Heinrich70/Heinrich-13-Di-70cc-hybrid-pitbike/Photos/motor assembly.jpg

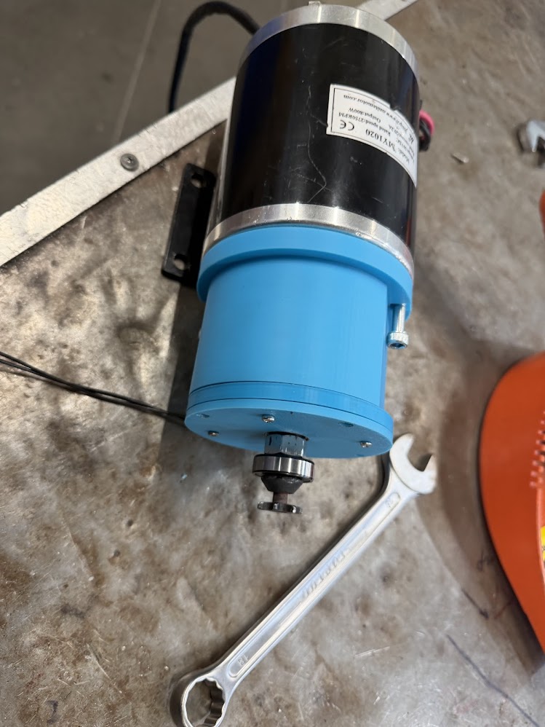
Photos/motor assembly.jpg
