Heinrich70/Heinrich-13-Di-70cc-hybrid-pitbike/Cad designs/PCBs/Fixed pptc.png

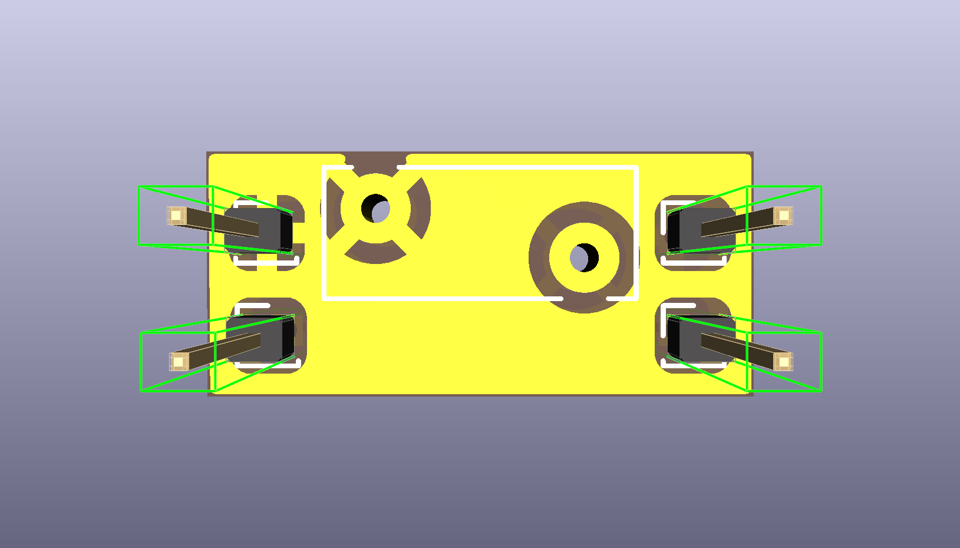
Cad designs/PCBs/Fixed pptc.png
