Heinrich70/Heinrich-13-Di-70cc-hybrid-pitbike/AS91904 Electronics Heinrich Venter.pptx

## AS91904 Electronics Outcome

Student Name: Heinrich venter
Project Name:hybrid pitbike

## Project Details

Describe your project here: This project is a hybrid 70cc pit bike that combines a petrol engine with an 800 W, 36 V electric motor to improve low-speed torque and acceleration. An ESP32 uses analogue and digital Hall effect sensors to monitor throttle position and engine speed, then controls the electric motor through a motor controller. An electromagnetic clutch engages the motor only when assistance is needed, creating a hybrid drivetrain that combines mechanical and electronic systems.

## Techniques used

Technique 1: Implementing communication protocols
Evidence:
I will meet this requirement by using I2C communication to connect the ESP32 to the OLED dashboard display. This allows important information such as speed and RPM data to be transferred to the display while only using two communication pins, leaving the remaining pins available for other sensors and system components.

Techniques could be:
implementing communication protocols
Wireless transfer of information
Feedback control
Implementing software flags and interrupts
CAD design, 3D printing, CNC, PCB making
filtering, noise and EMI suppression.

Technique 2: Filtering, noise and EMI suppression
Evidence:
I will meet this requirement by adding filtering components, such as 0.1µF ceramic capacitors, to reduce electrical noise caused by the high-current electric motor. This will improve the reliability of the Hall effect sensors, LED indicators, and battery monitoring system by providing more stable and accurate readings.

## Relevant Implications

Description of Implication (What Where Why) | Explanation of Implication (How, Why) | Evidence of addressing.
Accessibility for the pitbike means the bike’s controls, indicators, and basic functions need to be understandable and manageable for a range of riders. This includes clear visual indicators, easy-to-reach switches, and controls that don’t require excessive strength. | It is important because riders need to operate the hybrid system, throttle, and display safely without confusion. I will address this by using clearly labelled switches, simple control layouts, and making sure components like the electric–petrol mode indicator are easy to read. | This was done by coding and producing a dashboard with 2 lines of leds one for the motor rpm and the other for the engine rpm to see when the clutch has to disengage and when the gear on the engine has to change as well as a Oled screen to see the speed of the bike as well as a second screen for sensor values so that troubleshooting can be done on the fly without needing a phone (for simpler usability)
Usability relates to how easy it is to understand and use the pitbike’s hybrid systems, such as switching modes, checking battery levels, or starting the bike. The design needs to feel intuitive even for new riders. | It matters because if the interface is confusing, the rider could misuse the bike or struggle during operation. I will address this by keeping the hybrid controls simple, limiting unnecessary switches, and providing a logical layout similar to standard pitbikes so it feels familiar. | Mapping the analogue throttle Hall sensors linearly alongside the petrol throttle, using software constraints (constrain(throttlePercent, 0, 100)).
Functionality refers to how well the 70cc hybrid pitbike performs its intended purpose—delivering reliable petrol and electric operation, smooth power delivery, and stable riding. It also includes ensuring the components (battery, controller, mechanical systems) work together correctly. | It is important because the bike must be reliable and safe. I will address this by testing the hybrid system regularly, checking wiring, ensuring the mechanical and electrical parts don’t interfere with each other, and confirming that power output remains stable. | Offloading sensor pulses to low-overhead interrupts (enginePulse, matchPulse, motorPulse), allowing the VCU (vehicle control unit)to match shaft speeds before engaging the 24V clutch.
Aesthetics for the pitbike include the visual design—how the hybrid components are integrated, how tidy the wiring is, and the overall look of the bike. A clean, professional aesthetic helps the bike feel intentional rather than thrown together. | It is important because a well-presented bike improves user confidence and makes maintenance easier. I will address this by organising wiring neatly, using matching colours or covers, and ensuring added components blend with the original frame so the hybrid upgrade looks cohesive. | Consolidating loose jumper wires onto a custom dual-layer PCB enclosed in a watertight, form-fitting 3D-printed ABS structural housing shell.

## Original Design

Insert diagram here of electronics outcome
v

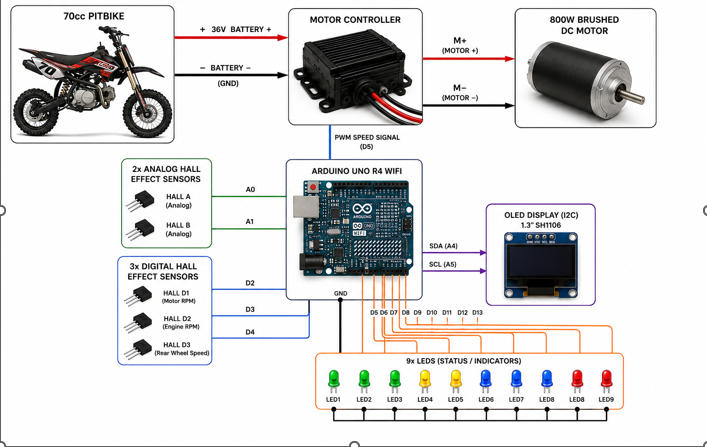
[picture p3: figure]

Made by ai

## Behaviour and function

The behaviour of the electronics is as follows.
Electric Motor Control
An analogue Hall effect sensor is used as the throttle input to send a signal to the 36 V motor controller, which controls the 800 W electric motor.
A 36 V to 12 V DC-DC buck converter is used to safely power the Arduino Uno R4 WiFi from the bike’s main battery system.
Hybrid Power Switching
A 24 V electromagnetic clutch is used to connect and disconnect the electric motor from the drivetrain.
Both the petrol engine and electric motor provide power during acceleration to improve low-speed torque.
At higher speeds, the electric motor disengages because the petrol engine can operate at a higher RPM.
A second Hall effect sensor is connected to the clutch lever, allowing the rider to manually disengage the electric motor when required.
RPM Matching System
Two digital Hall effect sensors measure the RPM on both sides of the electromagnetic clutch.
The Arduino uses this data to match the electric motor speed with the drivetrain before engaging the clutch, preventing drivetrain damage and sudden speed changes.

## Slide 7

Speed Monitoring
A digital Hall effect sensor mounted near the rear wheel measures wheel rotation speed.
The Arduino calculates the bike’s speed and displays it on the dashboard.
Dashboard Display
An OLED display and LED indicators provide the rider with real-time information.
The dashboard displays:
Vehicle speed
Engine RPM
Electric motor RPM
Battery percentage

## Explaining relevant communication protocols

I am using I2C communication between the ESP32and the OLED dashboard display. I2C works by using two communication lines: SDA (Serial Data) to transfer information and SCL (Serial Clock) to synchronise the data transfer. The ESP32 acts as the master device, sending information to the OLED display, which acts as the slave device. This allows the system to display real-time information such as speed rpm and current gear position aswell as sensor values so that the rider/user can diagnose the system if there is one and the don’t have access to the esp32s wifi signal

I selected I2C because it only requires two Arduino pins, leaving more available pins for the other sensors used in the bike, such as Hall effect sensors and RPM sensors. I2C also provides enough communication speed for a small OLED display while allowing additional devices to be added to the same communication bus in the future.

## Iterated Design

Feedback:

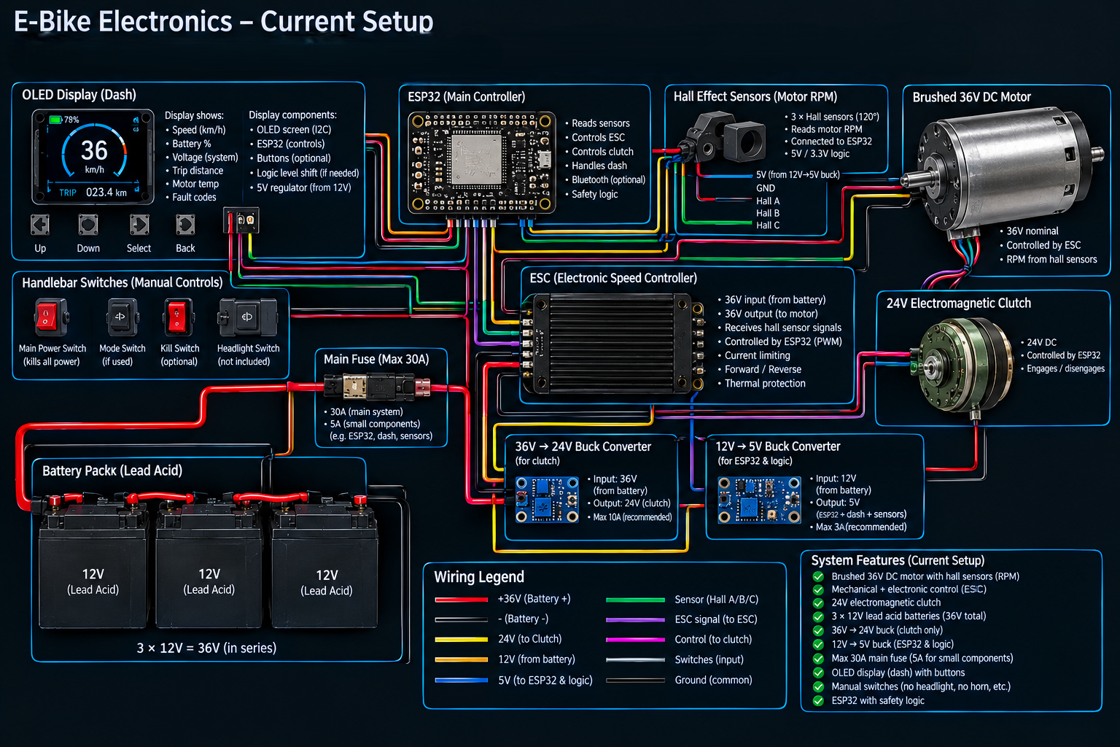
[picture p4: figure]

Made by ai

## Components and Systems

## Choice of Component/System 1: controller

Chosen
ESP32-s3

Alternative 1
Arduino r4 wifi

Alternative 2
Arduino r3

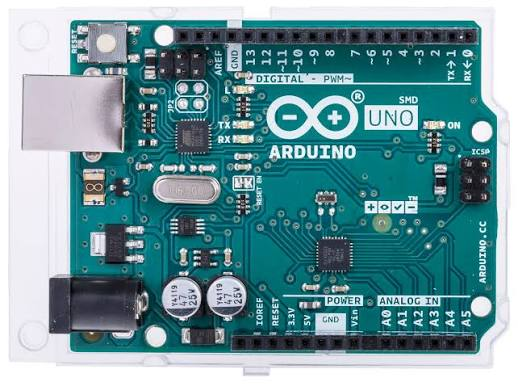
[picture p5: figure]
Arduino Uno Rev 3 SMD, A000073
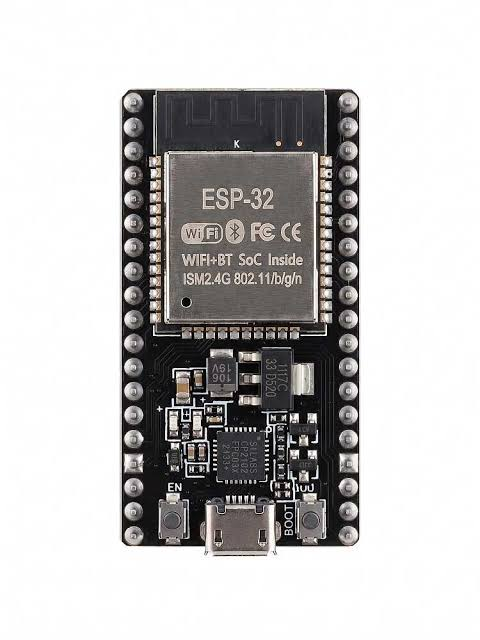
[picture p6: figure]
Buy ESP32 ESP-32S WiFi+ Bluetooth Development Board
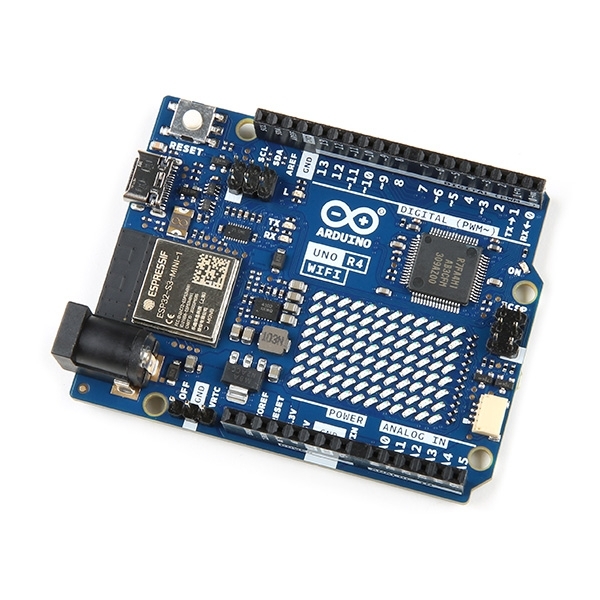
[picture p7: figure]
Arduino UNO R4 WiFi - SparkFun Electronics

Justification of choice made
I chose the esp32 for its native wifi and Bluetooth capabilities aswell as its increased gpio pins compared to other boards, another reason is that it is faster at reading sensor readings

## Component/System 1

Explanation of component-brain
The ESP32 is the main microcontroller used in my project. It is a microcontroller with a wifi component onboard meaning it can be controlled wirelessly using wifi, it also has gpio pins on the side so that sensors and components like a PCB can be added for adding more components

Component Picture

Component test log:
Have been found to be much more reliable and easier to use compared to the r4 and the r3 arduinos aswll as the wifi capabilities natively on the esp compared to the wifi connection on the r4

## Reliability Testing

Multiple test

Reliability notes from testing:When testing the original single-core Arduinos, the display setup had a bit of lag. Every time the controller had to refresh the OLED layout or stream data over the network, it would momentarily freeze up, missing live switch changes and slowing down the screen update rate. The hardware simply didn't have enough processing power to keep the graphical interface smooth while managing the wireless network connection at the same time.

Analyse notes from testing and note changes to be made:To fix the interface lag, I chose to use a dual-core ESP32 chip. This lets the processor handle multiple tasks at once: Core 0 runs the local code loop to handle instant switch inputs and refresh the U8g2 OLED screens without any delay, while Core 1 runs the background web server to host the JSON dashboard page. This ensures the live user interfaces update quickly and smoothly without crashing.

## Choice of Component/System 2:physical controls

Chosen
Hall effect sensor

Alternative 1
Potentiometer

Alternative 2
optical encoder

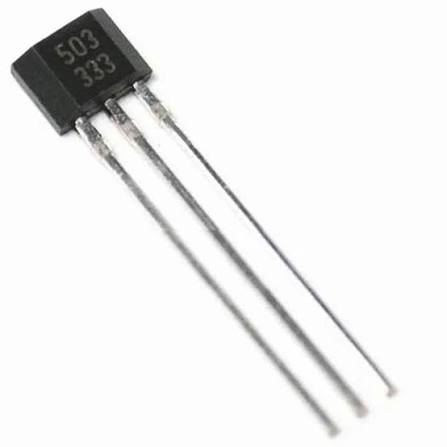
[picture p8: figure]
UGN3503UA Hall Effect Sensor | Afterpay & ZipPay Available | Click & Collect | Jaycar
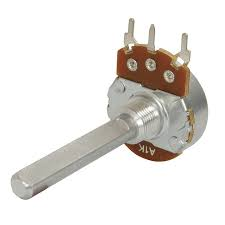
[picture p9: figure]
25k Ohm Logarithmic (A) Single Gang 24mm Potentiometer | Afterpay & ZipPay Available | Click & Collect | Jaycar
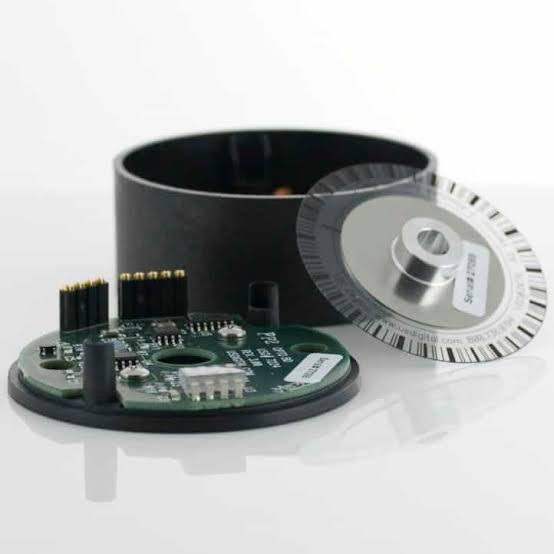
[picture p10: figure]
Optical Encoders: How They Work, Types & Applications

Justification of choice made
The reason why I chose the hall effect sensor is due to simplicity and the fact that it use magnets for signal input meaning nothing is touching so no friction and near zero wear in the parts, it is also very easy to make a custom casing for it to be held in place where ever its needed

## Component/System 2

Explanation of component-speed/rpm sensing
The speed and RPM tracking system uses digital Hall effect sensors with neodymium magnets attached to the rotating parts of the bike, including the clutches and rear wheel. When the magnet passes the sensor, it detects the change in the magnetic field and sends a digital signal (0V or 5V) to the Arduino. These signals are used by the Arduino to calculate the RPM of the drivetrain and the speed of the bike by measuring the time between each pulse.

Component Picture

Component Test Log:
there is a bit of electromagnetic interference from other magnets like the clutch and the engine, adding a 0.1uf capacitor across the signal and gnd wires did reduce this emi

## Reliability Testing

Multiple test

Reliability notes from testing: the analog hall sensors still have a little bit of bounce to its signal but still readable tho

Analyse notes from testing and note changes to be made: twisting the 3 wires ontop of eachother which creates an inductor which resist signal roughness

## Choice of Component/System 3

Chosen
1.3” i2c Oled screen

Alternative 1
Lcd screen

Alternative 2
SPI TFT colour display

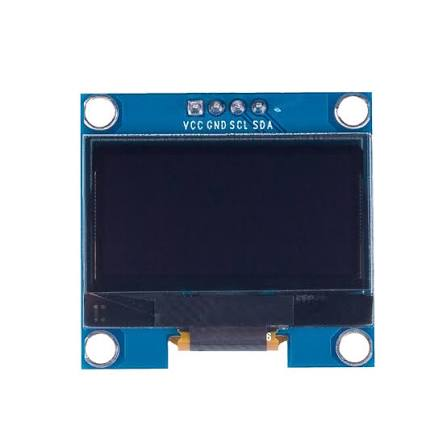
[picture p11: figure]
1.3" IIC I2C Serial 128x64 SSH1106 OLED Display Module | SunFounder
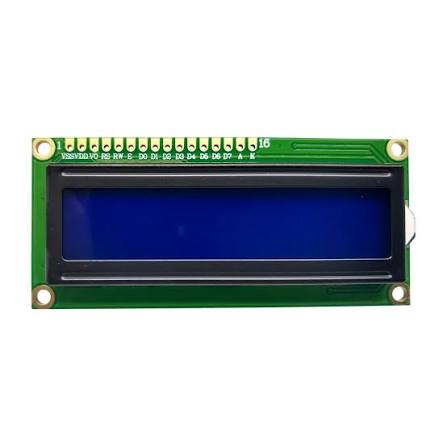
[picture p12: figure]
Dot Matrix White on Blue LCD 16x2 Character
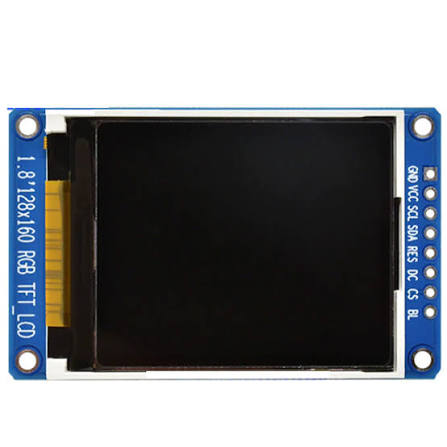
[picture p13: figure]
TFT LCD - Full Colour TFT LCD Display 1.8 inch(128x160) SPI Interface

Justification of choice made
The chosen 1.3" I2C OLED display was selected because it provides a clear and efficient way to display information from the ESP. It is not only bright enough to be seen in the day but only uses 4 wires (gnd, 3v3, sda and scl) (scl:serial clock sda: serial data) wich is also very easy to programme and controll

## Component/System 3

Explanation of component-dashboard:The dashboard provides the rider with a real-time visual interface displaying operational telemetry. It features a 1.3" SH1106 I2C OLED display running in tandem with a custom 16-LED tachometer bar driven by an MCP23017 port expander.

Component Picture

Component Test Log: it works very nicely hardware wise but programme wise its lagging a bit so a separate screen (on the same oled) will be added to show sensor values that can b controlled by s switch to cycle through the 2 screens

## Reliability Testing

Multiple test

Reliability notes from testing:When I tested the dashboard out in the open, I realized the bare screen and circuit board were completely exposed to the elements. If it rained or mud splashed up while riding, water could easily get onto the contacts and cause an environmental short circuit. The screen was also vibrating a lot on the handlebars, which could loosen the wires over time.

Analyse notes from testing and note changes to be made:
to prevent environmental short circuits, I designed a sealed handlebar mounting dashboard cluster using 3D-printed parts. I integrated a transparent acrylic faceplate and cut a custom, shock-absorbing TPU gasket to seal the electronics safely away from weather exposure.

## Choice of Component/System 4

Chosen
Electromangetic clutch

Alternative 1
Automatic Centrifugal Clutch Mechanism.

Alternative 2
One way bearing

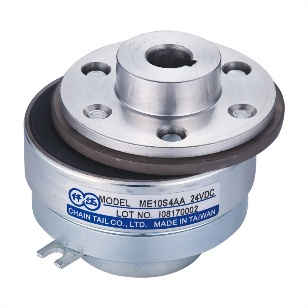
[picture p14: figure]
Chain Tail-ME1 Miniature Electromagnetic Bearing Mounted Clutch With Hub
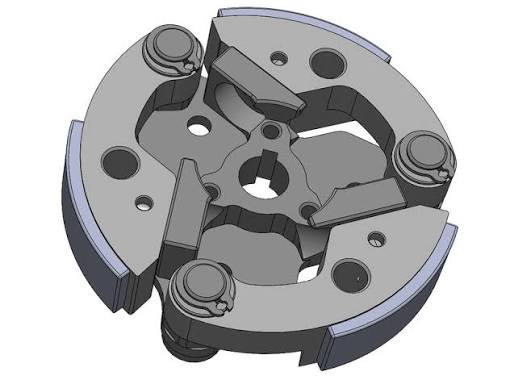
[picture p15: figure]
Three-shoe Centrifugal Clutch | Download Scientific Diagram
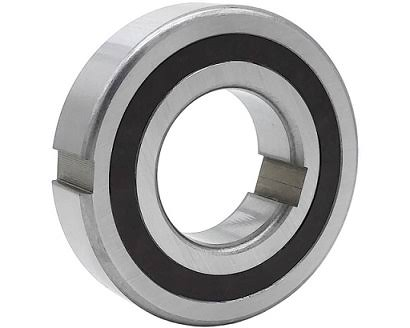
[picture p16: figure]
All about one way clutch bearing

Justification of choice made
I chose the electromagnetic clutch because, when a electric motor gets back driven it can cause something called back emf which is basically electric breaking but with a electromagnetic clutch yon can physically disconnect the 2 power units from each other specifically the electric motor which mean no back emf.

## Component/System 4

Explanation of component-electromagnetic clutch
The clutch system is used to connect and disconnect the 800W electric motor from the drivetrain. It uses a mechanical clutch mechanism controlled by a lever, with a sensor attached to detect when the clutch is being used. When the rider pulls the lever, the clutch disengages the motor from the drivetrain, allowing the motor to be safely disconnected. The sensor sends this information to the Arduino, allowing it to stop motor assistance and adjust the system accordingly.

Component Picture

Component Test Log:
The purpose of this test was to check that the manual clutch could reliably engage and disengage the 800W motor from the drivetrain. The clutch was connected to the motor system and tested under load to ensure it could separate the drive components correctly. Initial testing showed some resistance in the lever mechanism, causing the clutch plates to separate slowly. The linkage was cleaned, adjusted, and lubricated to fix this issue. After these changes, the clutch successfully completed ten engagement and disengagement tests without slipping, confirming that it worked correctly.

## Reliability Testing

Test your circuits at least 10 times

Reliability notes from testing:
Manual clutch assembly stress trials revealed initial instability and wobble, which were corrected by manually aligning the central hub to ensure proper clearance. Following this adjustment, the system demonstrated consistent, reliable performance throughout the remaining tests without mechanical failure.

Analysis Notes from Testing and Changes to be Made:
Testing showed that the high torque produced by the 800W motor puts significant load on the clutch assembly, making correct alignment important for reliable operation. Small amounts of misalignment can cause extra stress and increased wear on the drivetrain components. To improve the strength and reliability of the system, a custom sleeve will be manufactured to act as a central alignment piece. This will help keep the clutch and drivetrain components correctly positioned, reducing movement and improving long-term durability.

## Choice of Component/System 5

Chosen
PCB

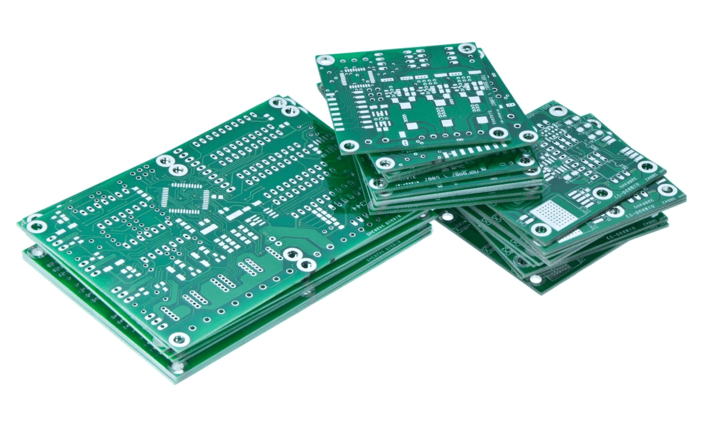
[picture p17: figure]
Printed Circuit Board Guide: PCB Design and Assembly

Alternative 1
Perfboard

Alternative 2
Strip boards

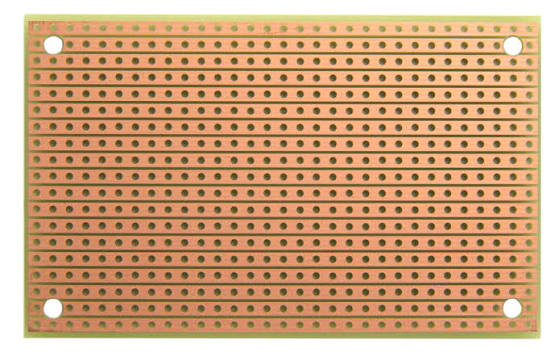
[picture p18: figure]
ST1 | StripBoard-Size 1 | BusBoard Prototype Systems
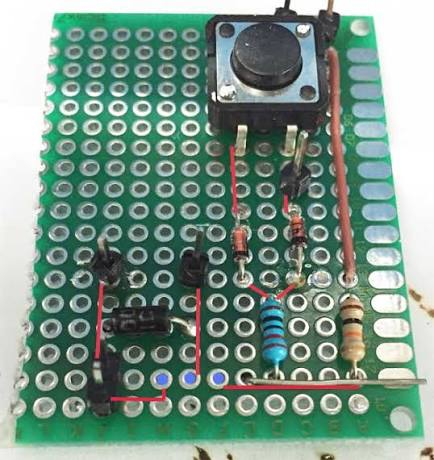
[picture p19: figure]
What to use to connect points on perf board - General Electronics - Arduino Forum

Justification of choice made
I chose a custom PCB because it gave me a cleaner and more reliable way of connecting all the electronics together. The PCB allowed me to place the Arduino, sensors, protection components and other circuits in one organised layout instead of having lots of separate wires. This was especially important because testing showed that electrical noise from the motor could affect the sensors. A PCB also made the final system more compact and reduced the chance of loose or incorrect connections.
I considered perfboard and stripboard, but both would have required more manual wiring and would have been harder to keep organised. The PCB was also easier to reproduce once the design was finished, making it the better choice for the final outcome.

## Component/System 5

Explanation of component-PCB
I designed a custom PCB to connect the Arduino UNO R4 to the different sensors and circuits used on the bike. It includes connections for the throttle and clutch Hall sensors, RPM sensors, battery voltage sensing, LEDs and the protection circuits. Having these connections on one board made the wiring cleaner and reduced the number of separate wires and connections. I also included filtering capacitors and protection components on the PCB based on problems found during testing. This made the final electronics more compact, organised and reliable.

Component Picture

Component Test Log: make sure to include protection to the circuit due to some components accidently being set to the wrong voltage can damage the delicate electronics in the system that when it gets damaged can cost a pretty penny to replace

## Reliability Testing

Test your circuits at least 10 times

Reliability notes from testing: I tested the PCB multiple times with the different circuits connected to make sure the board was reliable. I checked the sensor connections, battery voltage sensing, Arduino power connections and the protection circuits. During testing, I found that the high current from the motor could cause electrical noise and interference with the sensor signals, so 0.1 µF capacitors were added to the PCB to help filter the signals. I also included PPTC fuses on the PCB to protect the lower-current circuits if a fault or short circuit occurred. The electromagnetic clutch circuit was also protected with a Schottky diode and PPTC because testing showed that the electromagnet could release a high voltage back into the circuit when switched off. The PCB was then tested again with these changes to check that the sensors and protection circuits were working correctly and that the board could operate without damaging the Arduino or other components.

Analysis Notes from Testing and Changes to be made: The testing showed that the PCB needed both filtering and protection to be reliable when used with the rest of the bike. The 0.1 µF capacitors were added to reduce electrical noise, while the PPTC fuses gave the PCB protection from excessive current if a fault occurred. The Schottky diode was added to the clutch circuit to stop the voltage released by the electromagnet from travelling back through the PCB. These changes were made from the problems found during testing and improved the reliability of the final PCB by making the circuits more protected and less affected by the electrical noise from the motor.

## Final Outcome, Before Testing

Include a screenshot/video of the final outcome working before testing here

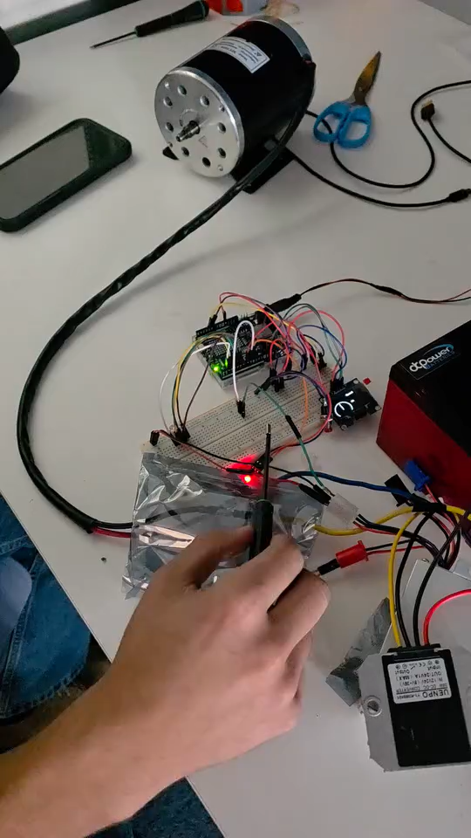
[picture p20: figure]
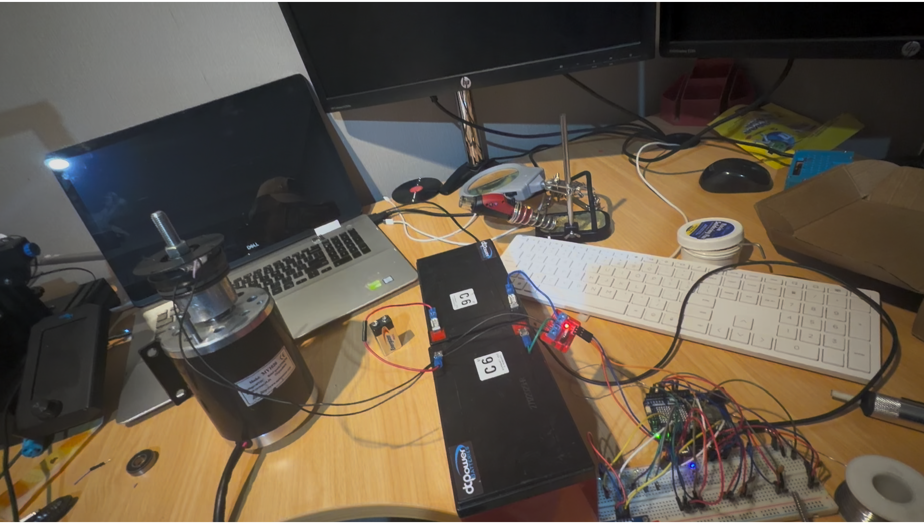
[picture p21: figure]

## Iteration of Development

Feedback on reliability and functionality of the system:
Some hybrid vehicles have a display that shows when the hybrid system is engaged. Adding a hybrid indicator light to the pitbike will let the rider know when the electric motor is assisting the petrol engine. This provides feedback that the hybrid system is working correctly and makes it easier to monitor the operation of the bike while riding.

Changes based off feedback (include picture or design):
An LED indicator/symbol will be added to the OLED display to show when the hybrid system is engaged. This gives the rider clear visual feedback that the electric motor is assisting the petrol engine and makes it easier to monitor the operation of the hybrid system while riding.

## Testing and Debugging

## Testing for functionality

Examples of testing, modifying and debugging include: using testing devices and testing strategies, testing expected, boundary and invalid inputs, changing board layout, improving component selection. You may test as you go

Project Specification | Test | Issues to be fixed, debugging, Notes
Electromagnetic clutch | Repeatedly engaged and disengaged the clutch using the ESP32-S3 microcontroller, driving an isolated optocoupled MOSFET switching loop. | issue: The clutch engaged reliably under software control, but mechanical alignment stress trials under load revealed structural shaft instability and clutch plate wobble. This slowed down plate separation and increased friction wear. Resolution: Machined a custom central steel sleeve component to act as a precision alignment piece. This completely eliminated the mechanical wobble, keeping the drivetrain components perfectly centered and ensuring long-term durability under heavy motor torque.
main PCB inside the dashboard | Plugged the PCB wit the Arduino inserted to the header pins. The Arduino fried due to unknown causes for the vin wasn’t plugged in and neither the voltage sensing, believed being the sensor wire for the throttle but in any case, it still broke. | Issue: Initial unshielded prototypes experienced catastrophic inductive feedback when switching off the electromagnetic clutch coil. The resulting ~200V inductive flyback spike traveled backward through the shared power rail, instantly frying the switching MOSFET and burning out the low-voltage microcontroller logic. Resolution: Redesigned the PCB layout to integrate a multi-stage hardware protection network. Wired a fast-acting Schottky diode in a reverse-biased configuration directly across the clutch coil leads to suppress inductive flyback spikes. Backed this up with a high-speed Zener d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
Throttle input/output | Handlebar grip rotation must shift the analogue input smoothly from 0.5V to 4.2V, mapped directly to a 0–100% PWM signal sent to the 36V high-voltage Electronic Speed Controller (ESC) to regulate the 800W motor | issue 1 (High-Voltage Failure): Initially, the PWM control signal trace was wired directly from the microcontroller to the ESC signal line. During high-load testing, common-ground voltage fluctuations and high-current spikes leaked directly backward from the 36V motor rail straight into the low-voltage electronics, completely frying the sensitive control circuit and blowing up the microprocessing chip. Resolution 1 (Galvanic Isolation): On the latest iterated PCB layout, I completely isolated the high-voltage drivetrain loop from the low-voltage logic gates by inserting a PC817 optocoupler i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

## Testing for reliability

Potential problem, original reliability | Test and change for reliability | Issues to be fixed, debugging, Notes
High-Frequency Electromagnetic Interference (EMI) along Data Rails | The digital Hall-effect RPM sensors were tested under full drivetrain load while running the 800W brushed DC motor. High-frequency electrical noise from the motor brushes induced phantom voltage spikes across the unshielded signal paths. | Diagnostic Outcome: Before filtering, the induced EMI noise caused severe sensor signal bounce and false edge-triggers, leading to corrupted, erratic RPM readings. Resolution: Soldered a 0.1µF ceramic decoupling capacitor in parallel directly across the VCC and GND pins of each sensor. Upstream signal lines were physically twisted into tight differential pairs along the frame rails. Retesting confirmed clean, stable pulse patterns with zero false triggers.
nductive Flyback Volts via Electromagnetic Coil Collapse | Cutting the power feed to the 24V electromagnetic clutch coil collapses its magnetic field, releasing a massive reverse-bias ~200V counter-EMF flyback spike back into the shared PCB power rail, risking total system destruction. | Diagnostic Outcome: Initial unshielded power cycles completely fried the switching MOSFET gates and instantly burned out the low-voltage microcontroller logic ports. Resolution: Engineered a multi-stage hardware protection network directly on the PCB traces. Wired a fast-switching Schottky diode in a reverse-biased configuration directly across the clutch coil leads to suppress inductive surges. Paired this with a high-speed Zener diode and a Transient Voltage Suppressor (TVS) diode to form a precise voltage clamp that shunts excess spike energy directly to ground. Added auto-resetting PPTC 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
Common-Ground Noise & High-Voltage Cross-Talk via PWM Signal Paths | Wiring the PWM throttle control trace directly from the microcontroller to the 36V high-voltage Electronic Speed Controller (ESC) allowed high-current surges and common-mode feedback to leak straight into the low-voltage control loop. | Diagnostic Outcome: High-amp draw spikes under hard acceleration bypassed the controller's internal logic gates, causing complete system failure and permanently destroying the microprocessing core. Resolution: Implemented absolute galvanic isolation on the latest dual-layer PCB layout by inserting a PC817 optocoupler directly into the PWM signal path. The ESP32-S3's internal LED controls the optocoupler using pure light transmission, completely breaking the physical electrical connection between the high-current 36V power system and the sensitive 5V/3.3V control electronics. This entirely el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

## Iteration after testing

- Feedback after testing:During integrated diagnostic testing of the system on the vehicle, two critical technical faults were discovered that severely limited operational reliability and data safety:
- Lack of Live Wireless Debugging: When tracking issues on a live vehicle moving under power, it was impossible to view sensor drifts or system states in real time using a standard hardwired serial monitor line, making calibration extremely slow and difficult.
- Volatile Memory Data Loss: The initial firmware layout calculated a runtime variable for the absolute highestSpeed reached. However, whenever the main power switch was killed or a PPTC circuit fuse reset the system, this critical data point was lost from the working RAM, preventing long-term tracking of drivetrain milestones.

Changes based off feedback (include picture or design):To completely address these feedback limitations, I executed a major dual-layered software iteration:
Asynchronous HTTP Data Server Integration: I embedded the <WiFi.h> and <WebServer.h> network libraries into the master ESP32-S3 software image. The controller is now programmed to configure a local Access Point routing node (SSID string pulled safely from SECRET_SSID). This architecture dynamically processes background web client connection requests and serves a live, structured JSON data packet string stream directly to the /data endpoint every 100ms. This permits non-blocking, real-time wireless diagnostics from a mobile phone browser interface while riding.
Non-Volatile NVS Preference Allocation: I integrated the core <Preferences.h> storage API framework to move structural variables out of volatile memory registers. Inside the processing loop, if a newly sampled wheelSpeed surpasses the stored record, the system automatically commits that float calculation straight into the ESP32-S3's non-volatile NVS flash memory partition under the namespace key "highest". This ensures telemetry records are saved safely during a complete vehicle power shutdown or automatic short-circuit fuse reset.
