Heinrich70/Heinrich-13-Di-70cc-hybrid-pitbike/AS91896-AS91906 Assessment Template.docx

# AS91896 or AS91906

# “Create an Advanced/Complex computer program”

Name:Heinrich Venter

Teacher: Mark Sutherland

Due Date:

## Project Brief

Please insert your brief statement in the following box

Create a plan for a program that will allow users to complete group bookings with a pricing total as per the brief.

2 different variables

2 if statements (or selection)

2 Loops

Output and input

Sequantial coding

2 of these Year 13’s:

- programming or writing code for a graphical user interface (GUI)
- reading from, or writing to, files or other persistent storage
- object-oriented programming using class(es) and objects defined by the student
- using types defined by the student
- using third party or non-core API, library or framework
- using complex data structures (e.g. stacks, queues, trees)

# Testing

This Section needs to be completed independently in order to get Merit or Higher.

Create a table here showing how you are going to test your application.

Test Scenario | Expected input and output | What actually happened | What need to be fixed
Throttle | So with the throttle insert inside the throttle assembly, when its twisted it should send a signal to the Arduino with its strength depending on how much the throttle is twisted, with this signal the Arduino puts out a pwm signal to the esc (electronic speed controller) to control how much throttle the esc gives | It sent a good signal when the throttle was twisted, but when the engine is spinning at a high rpm at the drive shaft x>2750rpm it will cause what is called “back emf” which resist the torsion of the motor and starts electrically braking the system | In the code using digital hall effect sensors to sense both the motor and drive shaft rpm, so that when the motor and drive shaft exceeds 2750rpm to shut the electromagnetic clutch off and physically shut the electric power system off
Clutch | Like the throttle the Clutch is controlled a linear hall effect sensor which is attached to the engine at the clutch leaver so when the clutch leaver is pulled it gets senced by the sensor and sends a signal to the arduino which then uses a Mosfet to shut the electromagnetic clutch on and off | It did work but a electromagnet is an inductor which holds flux and when the magnet gets switched off no more power is given and the magnet wants to resist that so a huge amount of back emf is produced to try and keep the flux in place which caused around 200v to surge back into the system not only frying the Mosfet but also the Arduino and this isn’t a good thing to happen while its being ridden | To not have this happen again we have to give the energy in the system to be released or atleast dissipate in the system over time the way we do that is one way electric valves called diodes so a Schottky diode (permanent one way valve) will be added and a Zener diode (pressure sensitive valve (will be closed when the circuit is being used but when it gets shut off and there is back emf pressure will open up) these diodes will be placed inn series across the anode and cathode of the electromagnet
Led matrix | There are 2 lines of leds doing one simple thing, showing the rpm of the engine and motor, this is detected using digital hall effect sensor which arnt linear they either give a high or low signal, so using that there is a magnet on the shafts of the engine and motor and a sensor counting the rpms of both units the Arduino then reads the signals and the outputs a voltage to the leds showing the rpms | The leds did word but were a bit bright | 1k ohm resistors will be added in serries to the leds to dim them a bit
OLed display | Using the same hall effect sensor on the drive shaft we can calculate the actual speed that the bike is actually traveling at by using the gear ratio and the circumference of the rear wheel in the programme, we can display this on an I2c Oled display on the dash next to the led matrixes | It worked for the most part when it was tested | Since the dashboard is very much exposed to the elements and the electronics arnt water proof I will be making a plexy glass face and printing a tpu gasket

## Boundary Tests (compulsory for Merit)

Boundary to be tested: control over the motor
Side 1 Input: clitched engaged | | Side 2 Input: clutch disengaged
Expected Output | Actual Outcome | Expected Outcome | Actual outcome
Motor able to spin | Motor was able to spin when clutch was enagaged | Motor isn’t able to spin | Motor wasn’t able to spin nop matter the input of the throttle

What Needs to be Fixed: in the gui add a system that means the threshold of when the clutch dis/engages so that so that the use has more control over clutch engagement

Boundary to be tested: throttle
Side 1 Input: low end | | Side 2 Input: high end
Expected Output | Actual Outcome | Expected Outcome | Actual outcome
Zero input | Low output that still effected the motor | Motor rpm max | worked

What Needs to be Fixed: make it so that when the throttle is lowest value make it so that output gives no pwm signal so that motor isn’t effected
Side 1 Input: low end/indle trottle | | Side 2 Input:high end/full trottle
Expected Output | Actual Outcome | Expected Outcome | Actual outcome
Zero inout | Zero signal to the motor | Full input | Full signal to motor

Test Scenario | Invalid Input | What actually happened | What need to be fixed
Motor rpm low | Out of range input, input mismatch, null value/no throttle input | Even with the throttle at a null value input the throttle output still gave a tiny voltage making the motor still spin | In the programme make it so that if throttle input value is 0 make it so that output is also 0
Clutch control | Clutch disengaged/ no input from sensor | When the throttle is pulled the throttle input should be locked out | N/A
LED dash board matrix | When clutch disengaged but motor still spinning meaning theire is still rpm | When the clutch disengaged the led matrix also turned off | Should not conform to clutch input should only show rpm of motor, so make so that it shows true rpm counts of motor and shows on dash
