Heinrich70/Heinrich-13-Di-70cc-hybrid-pitbike/Photos/battery placement image.jpg

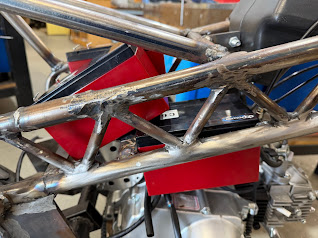
Photos/battery placement image.jpg
