Heinrich70/Heinrich-13-Di-70cc-hybrid-pitbike/Photos/bike (rolling).jpg

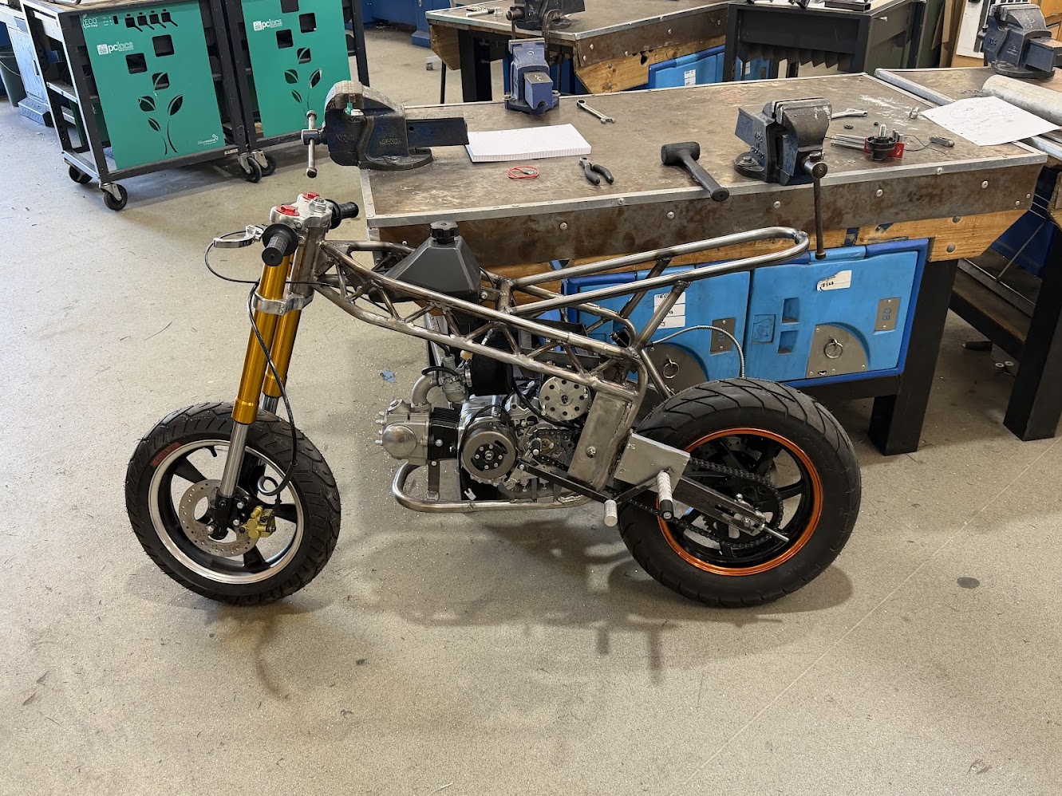
Photos/bike (rolling).jpg
