Heinrich70/Heinrich-13-Di-70cc-hybrid-pitbike/Photos/bottom dash on bike photo.jpg

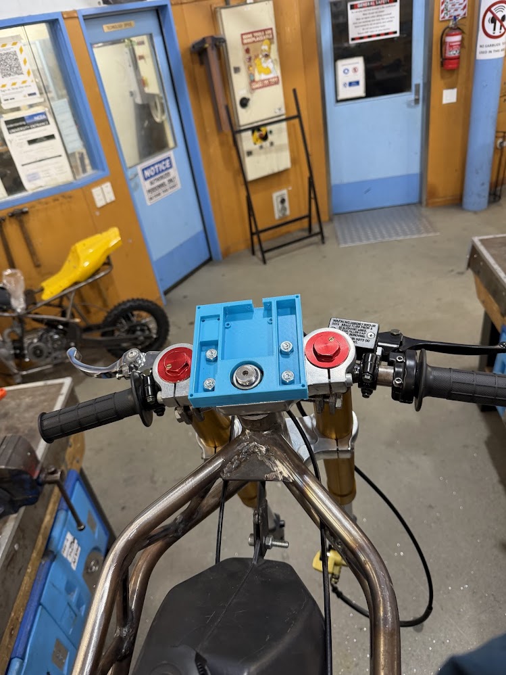
Photos/bottom dash on bike photo.jpg
