Heinrich70/Heinrich-13-Di-70cc-hybrid-pitbike/Photos/chain from motor.jpg

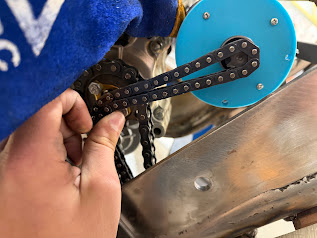
Photos/chain from motor.jpg
