Heinrich70/Heinrich-13-Di-70cc-hybrid-pitbike/Photos/clutch aluminium hub.jpg

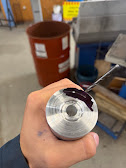
Photos/clutch aluminium hub.jpg
