Heinrich70/Heinrich-13-Di-70cc-hybrid-pitbike/Photos/motor in bike photo.jpg

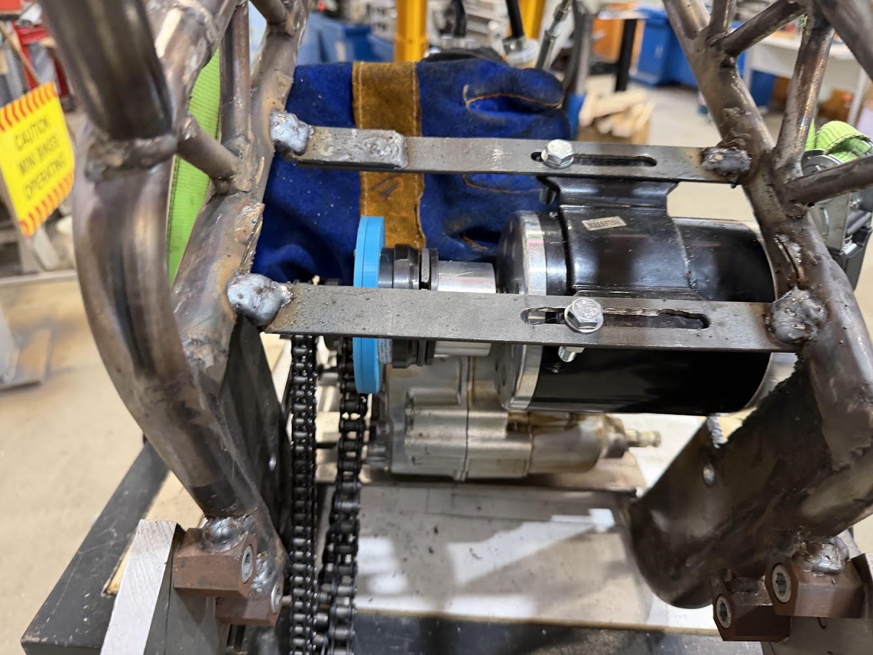
Photos/motor in bike photo.jpg
