Heinrich70/Heinrich-13-Di-70cc-hybrid-pitbike/Cad designs/3D prtints/second dashboard.stl

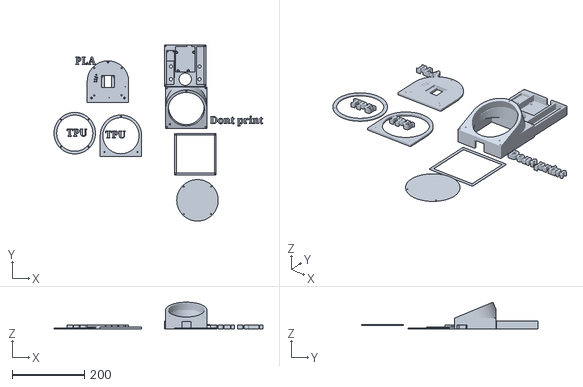
[picture p28: CAD file, 2026-08-18]
Cad designs/3D prtints/second dashboard.stl
579.0 x 488.0 x 73.9
