Heinrich70/Heinrich-13-Di-70cc-hybrid-pitbike/Cad designs/3D prtints/second throttle.stl

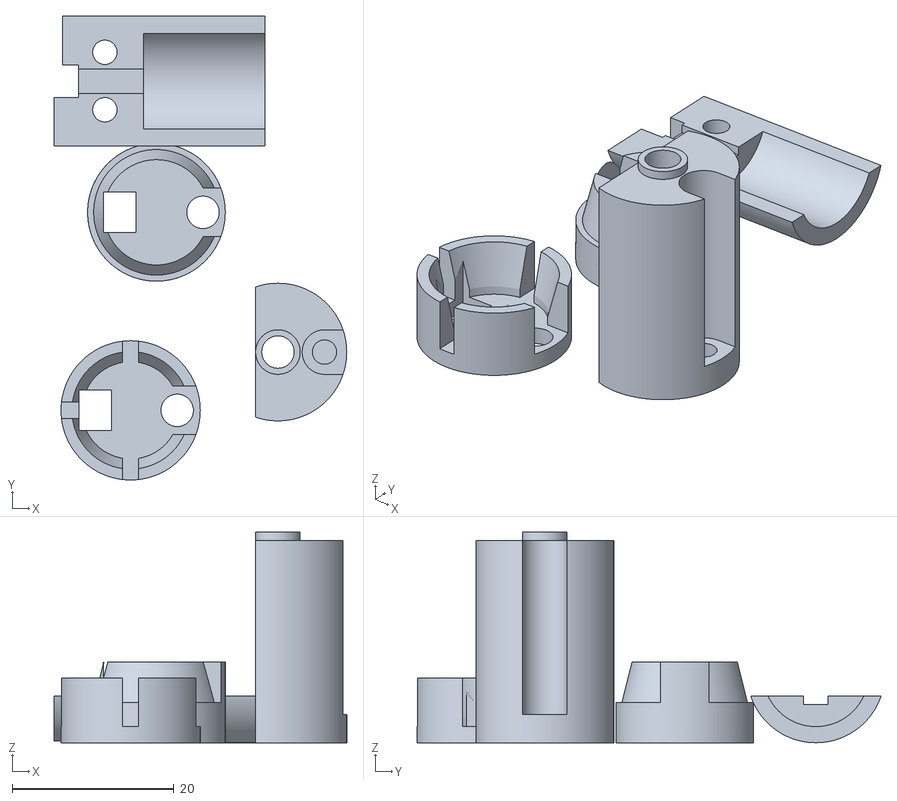
[picture p29: CAD file, 2026-07-26]
Cad designs/3D prtints/second throttle.stl
36.1 x 57.3 x 26.0
