Heinrich70/Heinrich-13-Di-70cc-hybrid-pitbike/Cad designs/3D prtints/first motor controll hub.stl

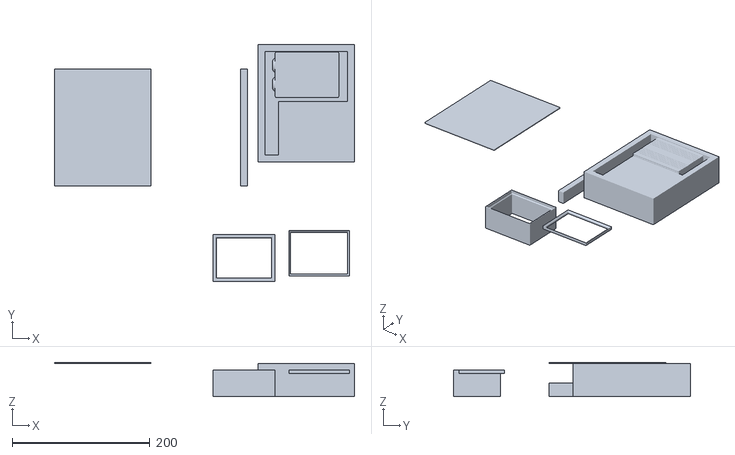
[picture p30: CAD file, 2026-07-26]
Cad designs/3D prtints/first motor controll hub.stl
435.0 x 343.0 x 50.0
