Heinrich70/Heinrich-13-Di-70cc-hybrid-pitbike/Cad designs/3D prtints/first throttle.stl

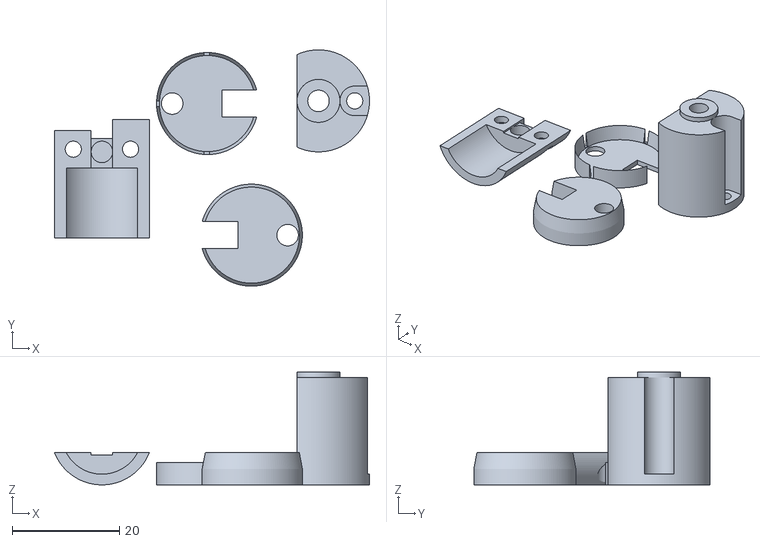
[picture p31: CAD file, 2026-07-26]
Cad designs/3D prtints/first throttle.stl
58.7 x 44.0 x 21.0
