Heinrich70/Heinrich-13-Di-70cc-hybrid-pitbike/Cad designs/3D prtints/second motor controll hub.stl

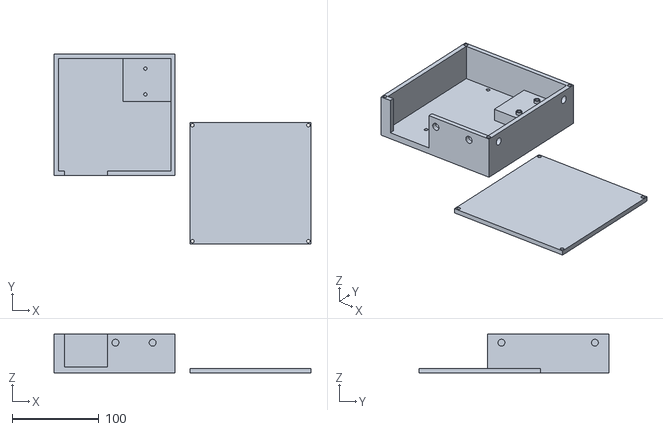
[picture p32: CAD file, 2026-07-26]
Cad designs/3D prtints/second motor controll hub.stl
297.0 x 219.0 x 45.0
