Heinrich70/Heinrich-13-Di-70cc-hybrid-pitbike/Cad designs/3D prtints/second clutch housing.stl

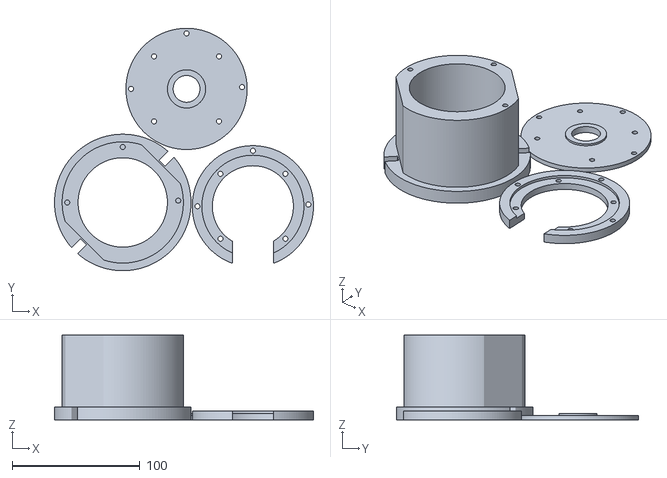
[picture p33: CAD file, 2026-07-26]
Cad designs/3D prtints/second clutch housing.stl
203.0 x 190.0 x 66.5
