Heinrich70/Heinrich-13-Di-70cc-hybrid-pitbike/Cad designs/3D prtints/first dashboard.stl

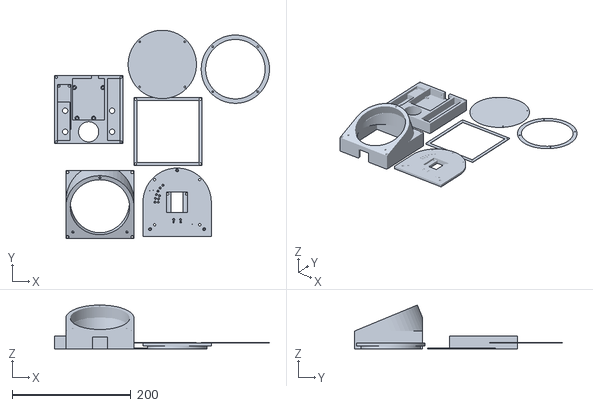
[picture p34: CAD file, 2026-07-26]
Cad designs/3D prtints/first dashboard.stl
362.0 x 351.0 x 73.9
