Heinrich70/Heinrich-13-Di-70cc-hybrid-pitbike/Cad designs/3D prtints/first clutch housing.stl

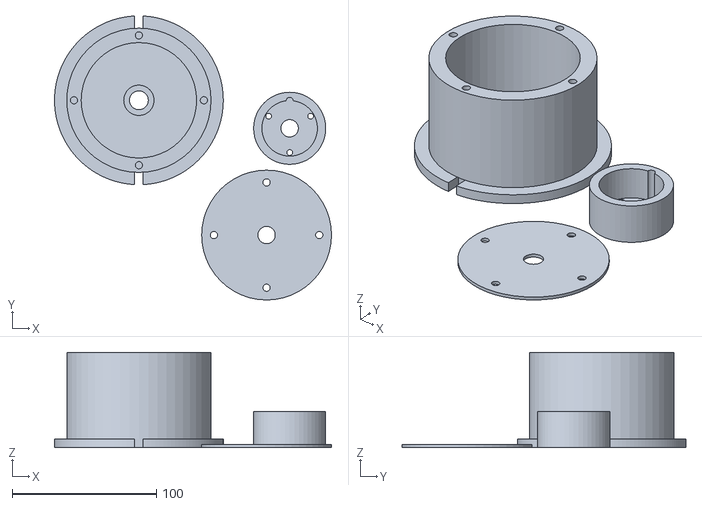
[picture p35: CAD file, 2026-07-26]
Cad designs/3D prtints/first clutch housing.stl
192.0 x 196.8 x 66.0
