Heinrich70/Heinrich-13-Di-70cc-hybrid-pitbike/Cad designs/3D prtints/clutch sensing box.stl

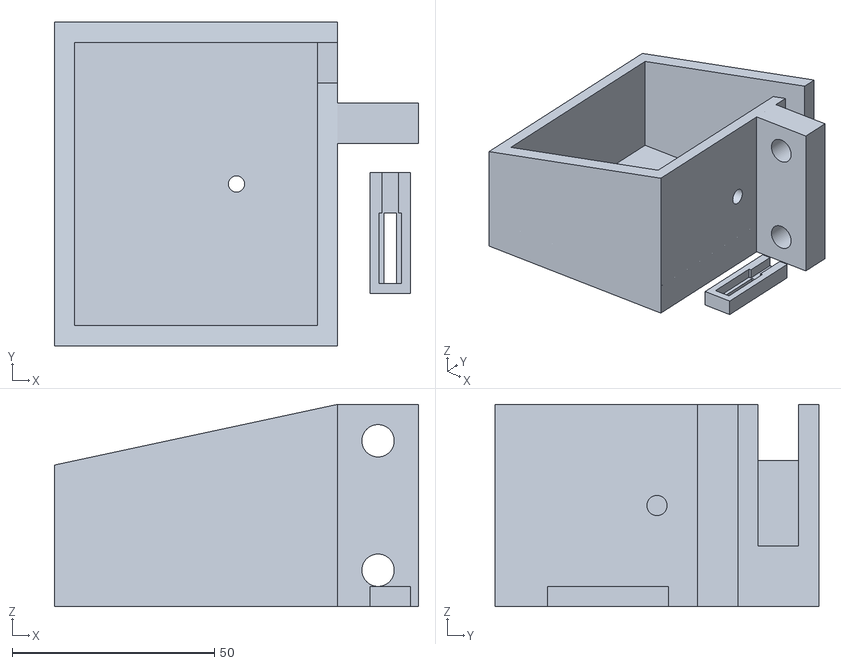
[picture p36: CAD file, 2026-07-26]
Cad designs/3D prtints/clutch sensing box.stl
90.0 x 80.0 x 50.0
