Heinrich70/Heinrich-13-Di-70cc-hybrid-pitbike/Cad designs/3D prtints/third clutch housing.stl

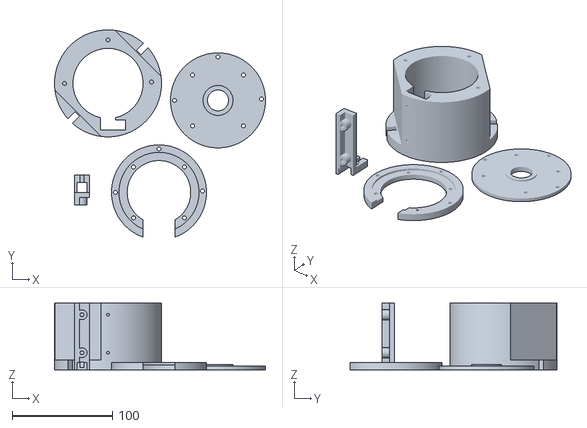
[picture p37: CAD file, 2026-07-26]
Cad designs/3D prtints/third clutch housing.stl
211.0 x 207.2 x 66.5
