Heinrich70/Heinrich-13-Di-70cc-hybrid-pitbike/Cad designs/3D prtints/charging system hub.stl

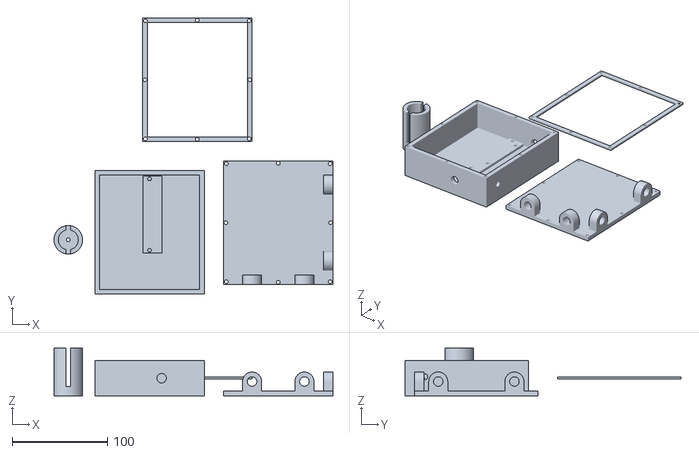
[picture p38: CAD file, 2026-07-26]
Cad designs/3D prtints/charging system hub.stl
293.0 x 290.0 x 50.0
