Heinrich70/Heinrich-13-Di-70cc-hybrid-pitbike/Cad designs/PCBs/Main/Main.kicad_pcb

## KiCad design Cad designs/PCBs/Main/Main.kicad_pcb (2026-08-12)

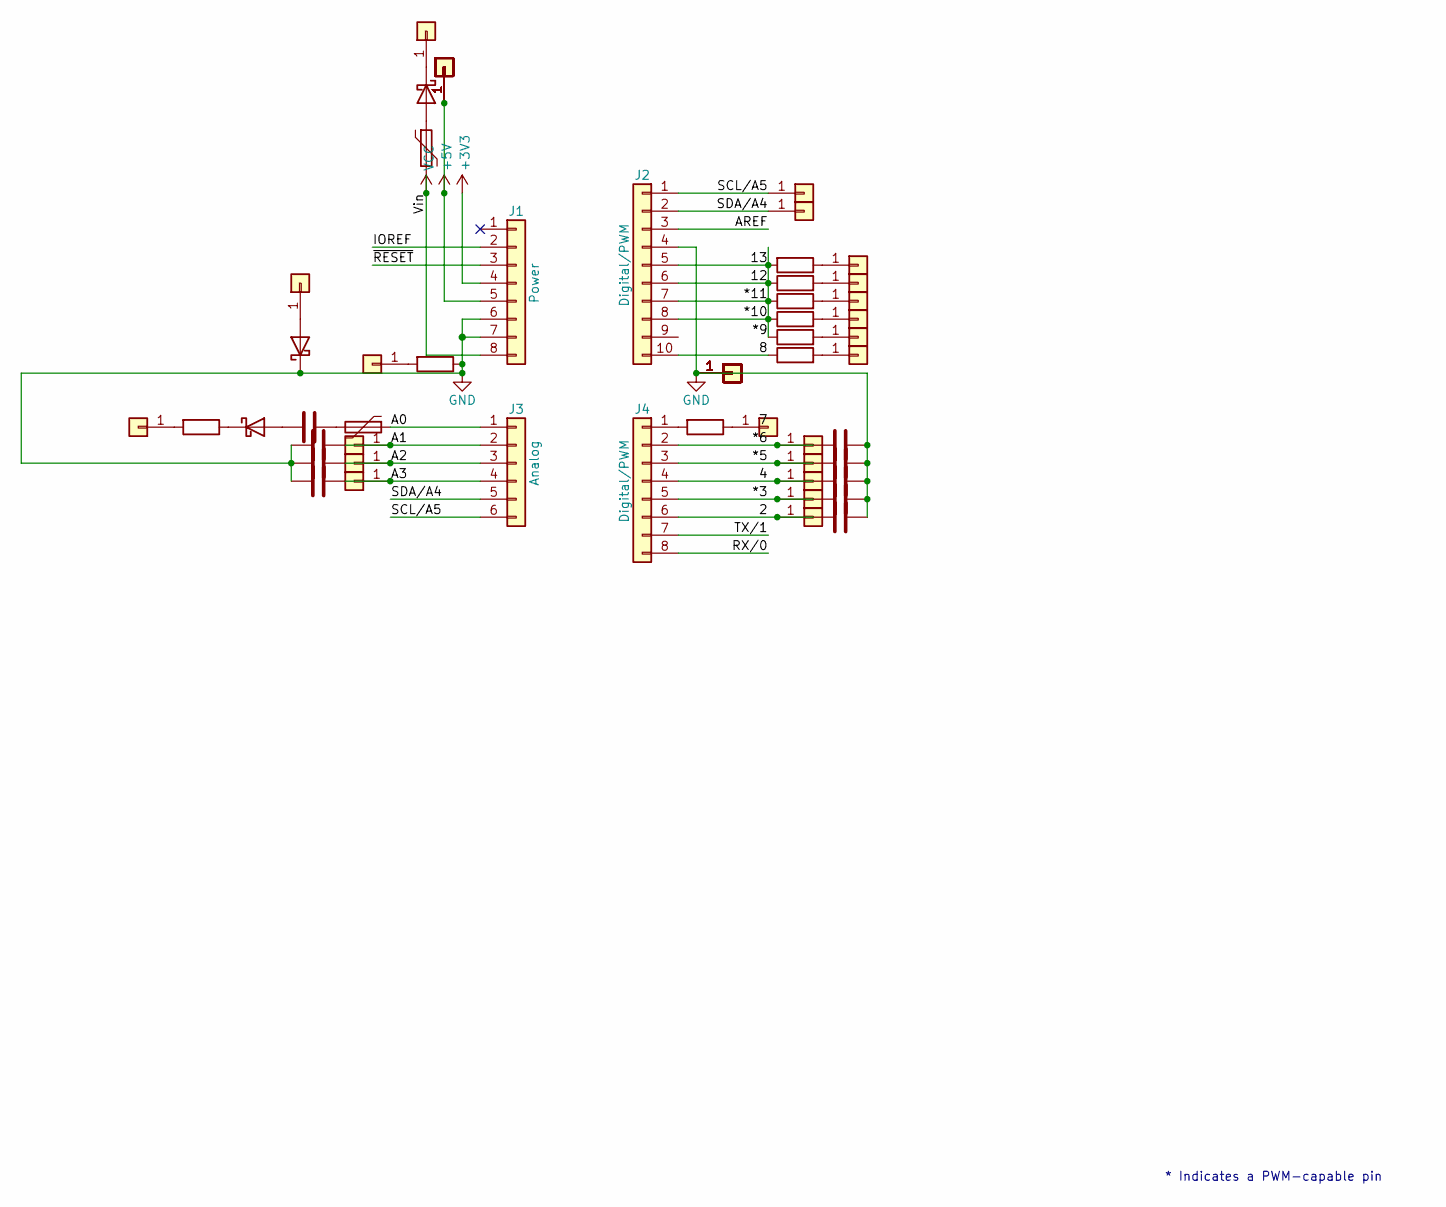
[picture p39: schematic Main.kicad_sch]

Parts:
C1, C2, C3, C4, C5, C6, C7, C8, C9: C; C_Disc_D5.0mm_W2.5mm_P2.50mm
D1, D2, D3: 1N5819; D_DO-201AD_P15.24mm_Horizontal
F1, F2: Polyfuse; Fuse_Bourns_MF-RHT050
J1: Power; PinSocket_1x08_P2.54mm_Vertical
J2: Digital/PWM; PinSocket_1x10_P2.54mm_Vertical
J3: Analog; PinSocket_1x06_P2.54mm_Vertical
J4: Digital/PWM; PinSocket_1x08_P2.54mm_Vertical
J5, J6, J7, J8, J9, J10, J11, J12, J13, J14, J15, J16, J17, J18, J19, J20, J21, J22, J23, J24, J25, J26, J27, J28, J29, J30, J31, J32, J33, J34, J35, J36, J37, J38, J39, J40, J41, J42, J43, J44, J45, J46, J47, J48, J49, J50: Conn_01x01; SolderWire-0.127sqmm_1x01_D0.48mm_OD1mm
R1, R2, R3, R4, R5, R6, R7, R8, R9: R; R_Axial_DIN0207_L6.3mm_D2.5mm_P7.62mm_Horizontal

Connections:
+3V3: J1.4
+5V: J1.5, J22.1 (Pin_1_1), J23.1 (Pin_1_1), J27.1 (Pin_1_1), J28.1 (Pin_1_1), J29.1 (Pin_1_1), J33.1 (Pin_1_1), J34.1 (Pin_1_1), J35.1 (Pin_1_1), J36.1 (Pin_1_1)
/2: C5.1, J4.6, J43.1 (Pin_1_1)
/4: C7.1, J4.4, J41.1 (Pin_1_1)
/8: J2.10, R2.1
/*3: C8.1, J4.5, J42.1 (Pin_1_1)
/*5: C3.1, J4.3, J40.1 (Pin_1_1)
/*6: C4.1, J4.2, J39.1 (Pin_1_1)
/*10: J2.5, J2.6, J2.7, J2.8, R3.1, R4.1, R5.1, R6.1, R7.2
/A0: F2.1, J3.1
/A1: C9.1, J3.2, J44.1 (Pin_1_1)
/A2: C6.1, J3.3, J45.1 (Pin_1_1)
/A3: C2.1, J3.4, J46.1 (Pin_1_1)
/AREF: J2.3
/IOREF: J1.2
/RX/0: J4.8
/SCL/A5: J2.1, J3.6, J10.1 (Pin_1_1)
/SDA/A4: J2.2, J3.5, J31.1 (Pin_1_1)
/TX/1: J4.7
/~RESET: J1.3
GND: C2.2, C3.2, C4.2, C5.2, C6.2, C7.2, C8.2, C9.2, D3.1 (K), J1.6, J1.7, J2.4, J5.1 (Pin_1_1), J6.1 (Pin_1_1), J7.1 (Pin_1_1), J8.1 (Pin_1_1), J9.1 (Pin_1_1), J11.1 (Pin_1_1), J12.1 (Pin_1_1), J13.1 (Pin_1_1), J14.1 (Pin_1_1), J15.1 (Pin_1_1), J16.1 (Pin_1_1), J17.1 (Pin_1_1), J18.1 (Pin_1_1), J19.1 (Pin_1_1), J20.1 (Pin_1_1), J21.1 (Pin_1_1), R9.1
unnamed: C1.1, F2.2
unnamed: C1.2, D1.2 (A)
unnamed: D1.1 (K), R8.1
unnamed: D2.2 (A), F1.1
unnamed: D2.1 (K), J47.1 (Pin_1_1)
unnamed: D3.2 (A), J50.1 (Pin_1_1)
unnamed: J4.1, R1.2
unnamed: J24.1 (Pin_1_1), R2.2
unnamed: J25.1 (Pin_1_1), R3.2
unnamed: J26.1 (Pin_1_1), R6.2
unnamed: J30.1 (Pin_1_1), R4.2
unnamed: J32.1 (Pin_1_1), R1.1
unnamed: J37.1 (Pin_1_1), R7.1
unnamed: J38.1 (Pin_1_1), R5.2
unnamed: J48.1 (Pin_1_1), R8.2
unnamed: J49.1 (Pin_1_1), R9.2
VCC: F1.2, J1.8

Notes on the sheet:
* Indicates a PWM-capable pin

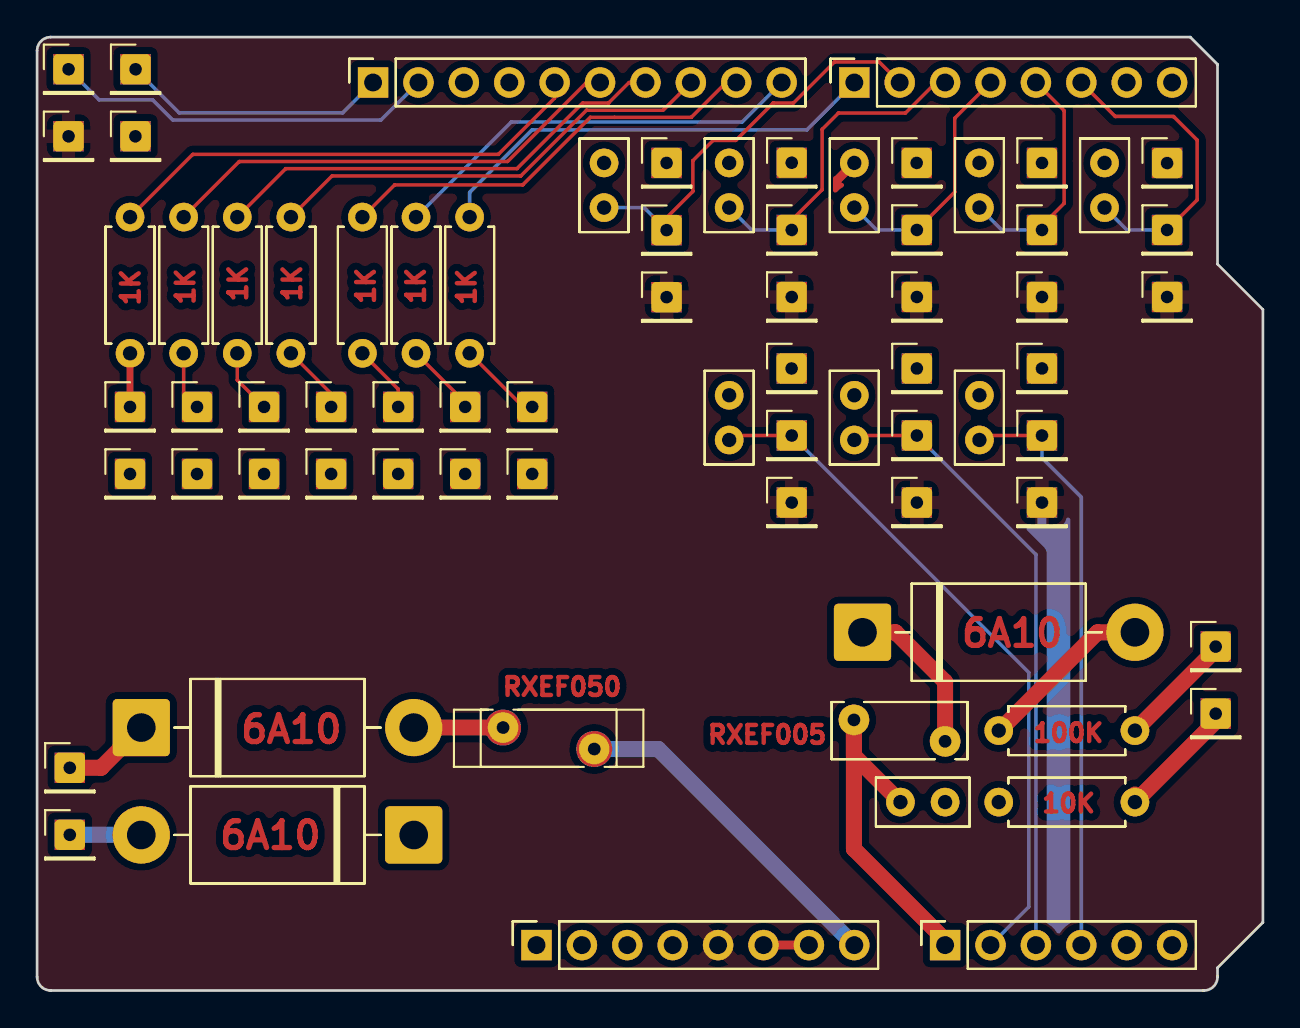
[picture p40: board Main.kicad_pcb from above]

Board: 2 copper layers, 68.6 x 53.3 mm, 73 parts (0 on the bottom side), 32 nets.
