Heinrich70/Heinrich-13-Di-70cc-hybrid-pitbike/Cad designs/PCBs/PPTC/PPTC PCB/PPTC PCB.kicad_pcb

## KiCad design Cad designs/PCBs/PPTC/PPTC PCB/PPTC PCB.kicad_pcb (2026-08-12)

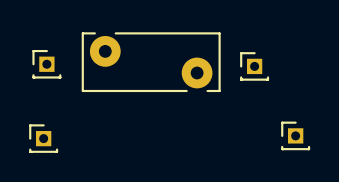
[picture p41: board PPTC PCB.kicad_pcb from above]

Board: 2 copper layers, 5 parts (0 on the bottom side), 3 nets, no tracks yet.

Parts:
F1: Polyfuse; Fuse_Bourns_MF-RHT050
J1, J2, J3, J4: Conn_01x01; PinHeader_1x01_P1.00mm_Vertical

Connections:
unnamed: F1.2, J1.1 (Pin_1_1)
unnamed: J2.1 (Pin_1_1), J4.1 (Pin_1_1)
unnamed: F1.1, J3.1 (Pin_1_1)
