Heinrich70/Heinrich-13-Di-70cc-hybrid-pitbike/Cad designs/PCBs/clutch protection ciucuit/clutch protection circuit.kicad_pcb

## KiCad design Cad designs/PCBs/clutch protection ciucuit/clutch protection circuit.kicad_pcb (2026-08-11)

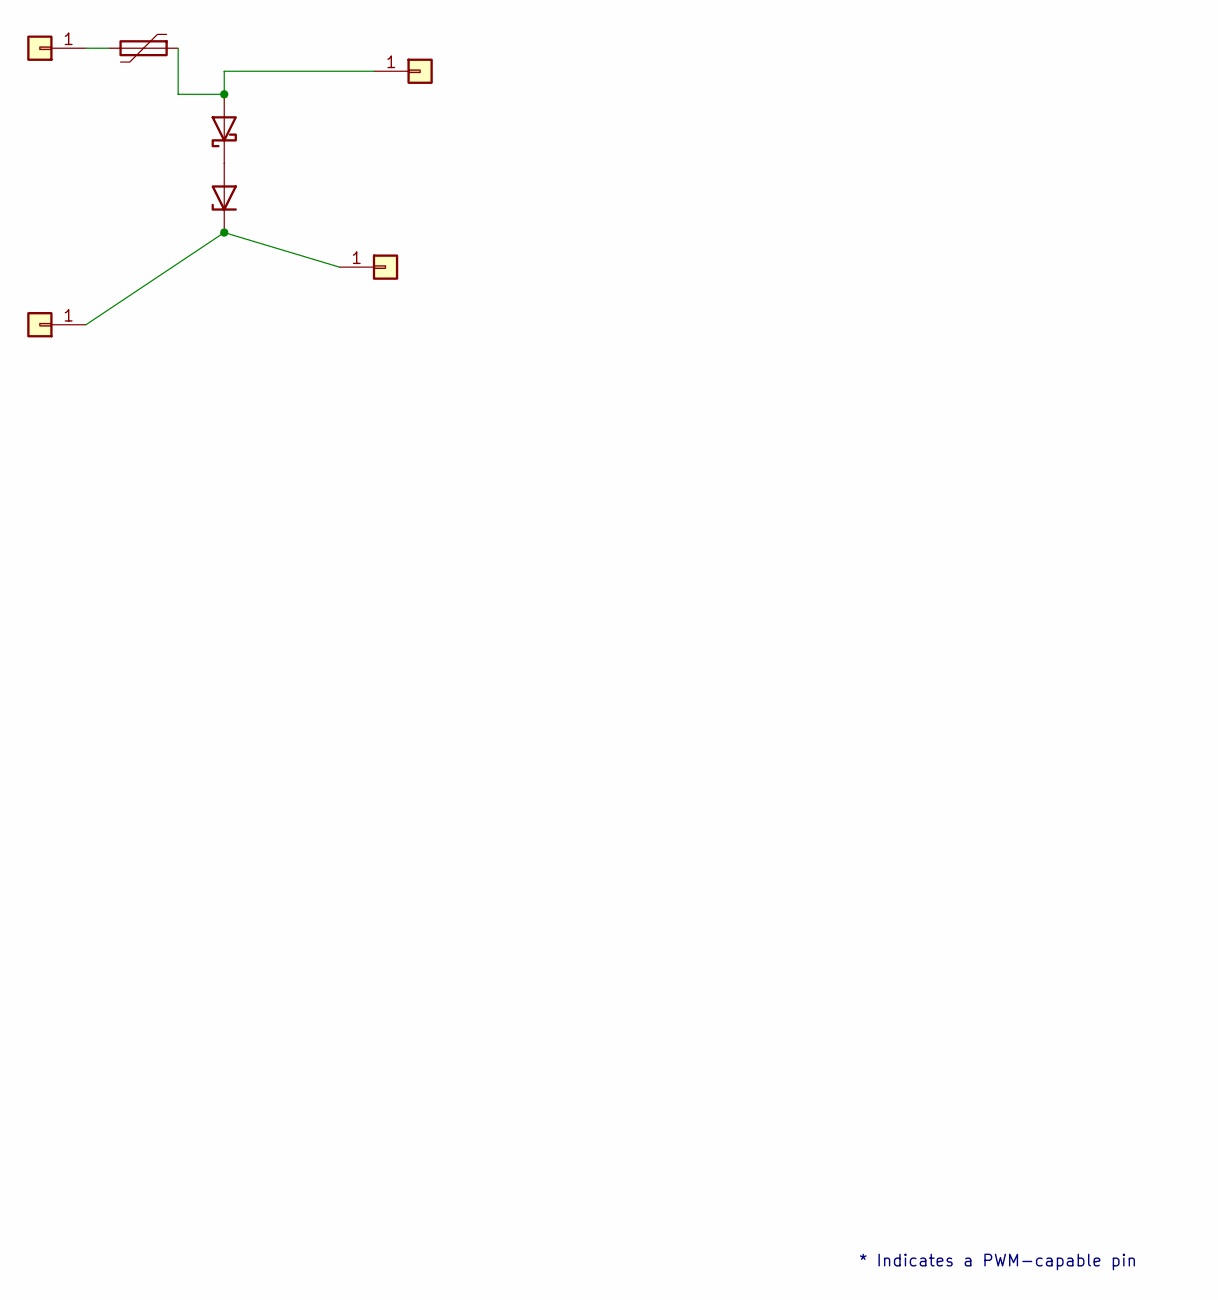
[picture p42: schematic clutch protection circuit.kicad_sch]

Parts:
D1: 1N47xxA; D_DO-41_SOD81_P10.16mm_Horizontal
D2: 1N5819; D_DO-41_SOD81_P10.16mm_Horizontal
F1: Polyfuse; Fuse_Bourns_MF-RHT050
J1, J2, J3, J4: Conn_01x01; PinHeader_1x01_P1.00mm_Vertical

Connections:
unnamed: D1.2 (A), D2.1 (K)
unnamed: D1.1 (K), J2.1 (Pin_1_1), J3.1 (Pin_1_1)
unnamed: D2.2 (A), F1.1, J1.1 (Pin_1_1)
unnamed: F1.2, J4.1 (Pin_1_1)

Notes on the sheet:
* Indicates a PWM-capable pin

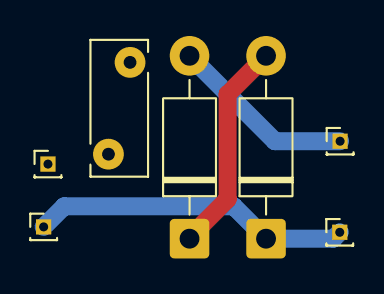
[picture p43: board clutch protection circuit.kicad_pcb from above]

Board: 2 copper layers, 7 parts (0 on the bottom side), 4 nets.
